ionescuionut1708/aquatemp-control/(notices)

Notices in the files:
README.md:
License: MIT
